DB0ANN/db0ann-beacon-hw/README.md

# db0ann-beacon-hw
Hardware documentation of db0ann beacon
