DB0ANN/db0ann-beacon-hw/beacon-control-ng/Pinning-list-uC.md

Micro controler Pinning list

| Pin | Type | Port  | Net Name | 5V Tolerant |
|-----|---|---|---|---|
| 1 | Supply  | V_BAT | +3.3V | n/a |
| 2 | I/O | PC13  | X_IO2 | No |
| 3 | I/O | PC14  | X_IO3 | No |
| 4 | I/O | PC15  | X_IO1 | No |
| 5 | In | PD0 | RCC_OSC_IN | No |
| 6 | Out | PD1 | RCC_OSC_OUT | No |
| 7 | In | NRST  | RST | No |
| 8 | Analog  | PC0 | AIN10 | No |
| 9 | Analog  | PC1 | AIN11 | No |
| 10  | Analog  | PC2 | AIN12 | No |
| 11  | Analog  | PC3 | AIN13 | No |
| 12  | Supply  | V_SSA | GND | n/a |
| 13  | Supply  | V_DDA | VDDA/+3.3V | n/a |
| 14  | Analog  | PA0 | AIN0 | No |
| 15  | Analog  | PA1 | AIN1 | No |
| 16  | Out | PA2 | UART_TX | No |

| Pin | Type | Port  | Net Name | 5V Tolerant |
|-----|---|---|---|---|
| 17  | In | PA3 | UART_RX | No |
| 18  | Supply  | V_SS4 | GND | n/a |
| 19  | Supply  | V_DD4 | +3.3V | n/a |
| 20  | Out | PA4 | SW_E | No |
| 21  | Out | PA5 | SW_D | No |
| 22  | Out | PA6 | SW_C | No |
| 23  | Out | PA7 | SW_B | No |
| 24  | Out | PC4 | SW_A | No |
| 25  | Out | PC5 | SW_H | No |
| 26  | Out | PB0 | SW_J | No |
| 27  | Out | PB1 | SW_I | No |
| 28  | Out | PB2 | SW_G | Yes |
| 29  | Out | PB10  | SW_F | Yes |
| 30  | In | PB11  | FRONT_KEY_F | Yes |
| 31  | Supply  | V_SS1 | GND | n/a |
| 32  | Supply  | V_DD1 | +3.3V | n/a |

| Pin | Type | Port  | Net Name | 5V Tolerant |
|-----|---|---|---|---|
| 33  | In | PB12  | J_F | Yes |
| 34  | In | PB13  | I_F | Yes |
| 35  | In | PB14  | H_F | Yes |
| 36  | In | PB15  | G_F | Yes |
| 37  | In | PC6 | F_F | Yes |
| 38  | In | PC7 | E_F | Yes |
| 39  | In | PC8 | D_F | Yes |
| 40  | In | PC9 | C_F | Yes |
| 41  | In | PA8 | B_F | Yes |
| 42  | In | PA9 | A_F | Yes |
| 43  | In | PA10  | ~J_F | Yes |
| 44  | In | PA11  | ~I_F | Yes |
| 45  | In | PA12  | ~H_F | Yes |
| 46  | Out_I/O | PA13  | JTAG_TMS_SWDIO | Yes |
| 47  | Supply  | V_SS2 | GND | n/a |
| 48  | Supply  | V_DD2 | +3.3V | n/a |

| Pin | Type | Port  | Net Name | 5V Tolerant |
|-----|---|---|---|---|
| 49  | Out | PA14  | JTAG_TCK_SWCLK | Yes |
| 50  | Out | PA15  | JTAG_TDI | Yes |
| 51  | In | PC10  | ~G_F | Yes |
| 52  | In | PC11  | ~F_F | Yes |
| 53  | In | PC12  | ~E_F | Yes |
| 54  | In | PD2 | ~D_F | Yes |
| 55  | In | PB3 | JTAG_TDO_SWO | Yes |
| 56  | In | PB4 | ~C_F | Yes |
| 57  | Out | PB5 | CW_GEN | ? |
| 58  | In | PB6 | ~B_F | Yes |
| 59  | In | PB7 | ~A_F | Yes |
| 60  | In | BOOT0 | Boot | ? |
| 61  | Out | PB8 | I2C1_SCL | Yes |
| 62  | I/O | PB9 | I2C1_SDA | Yes |
| 63  | Supply  | V_SS3 | GND | n/a |
| 64  | Supply  | V_DD3 | +3.3V | n/a |
