DB0ANN/db0ann-beacon-hw/beacon-control-ng/beacon-control-ng.kicad_pcb

## KiCad design beacon-control-ng/beacon-control-ng.kicad_pcb (2020-06-21)

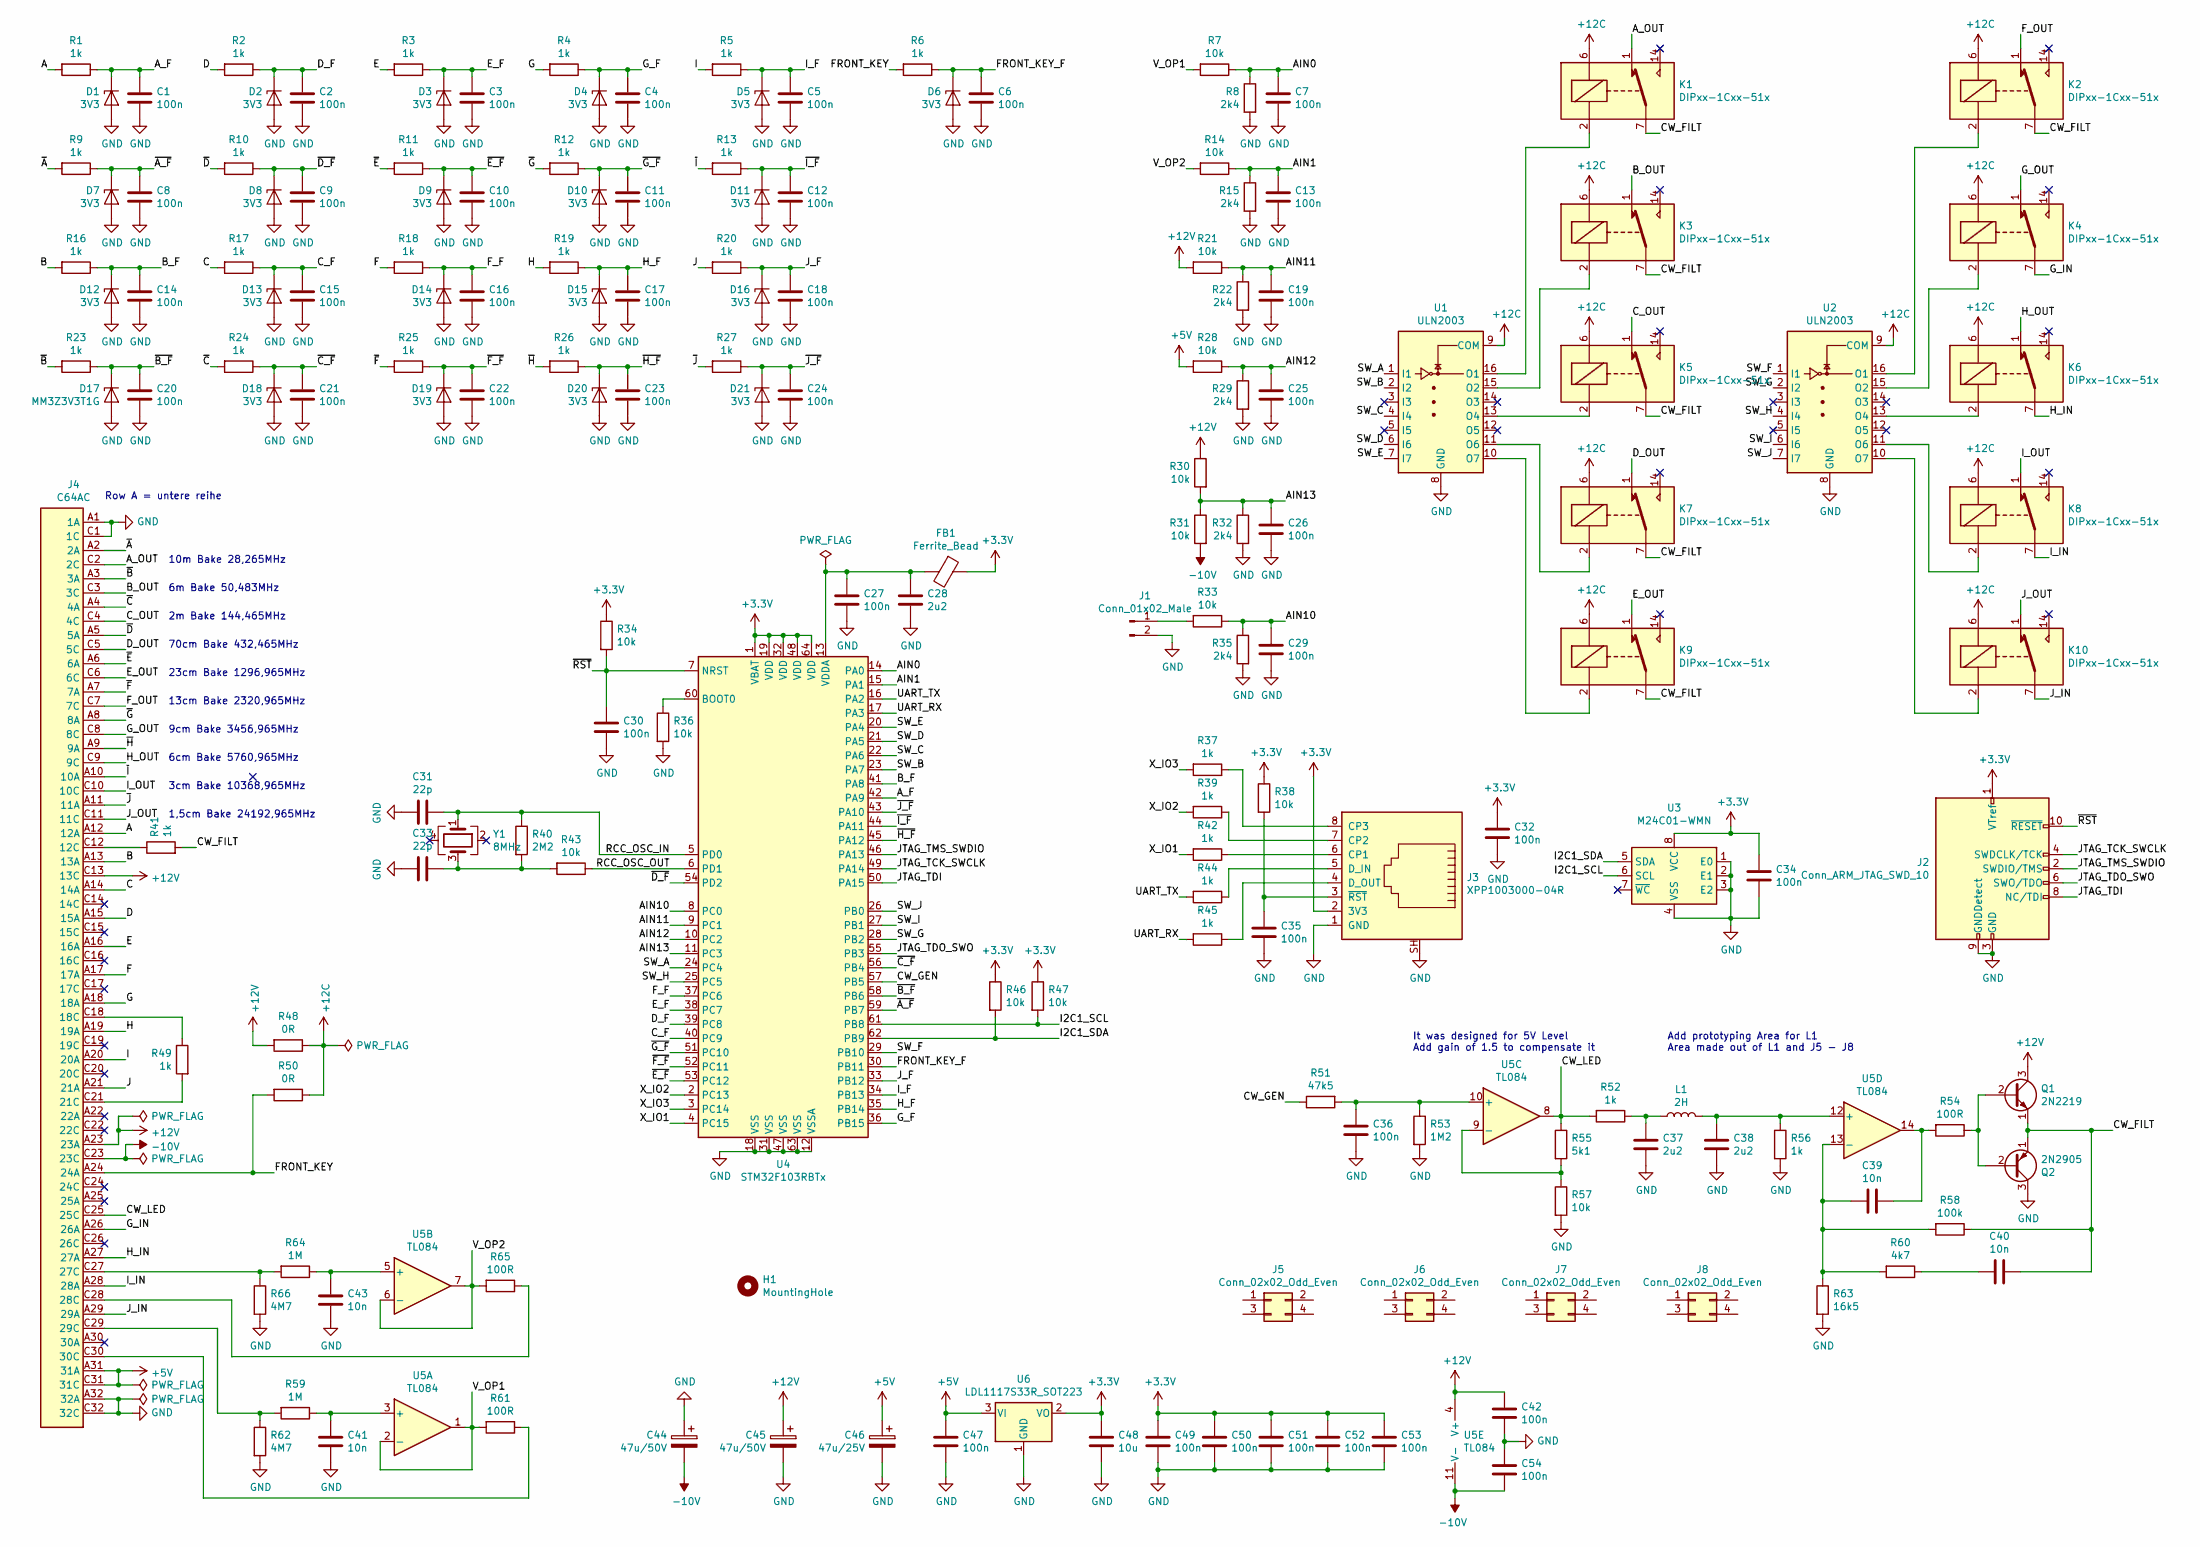
[picture p1: schematic beacon-control-ng.sch, beacon control ng]

Parts:
C1, C2, C3, C4, C5, C6, C7, C8, C9, C10, C11, C12, C13, C14, C15, C16, C17, C18, C19, C20, C21, C22, C23, C24, C25, C26, C27, C29, C30, C32, C34, C35, C36, C42, C47, C49, C50, C51, C52, C53, C54: 100n; C_0805_2012Metric
C28, C37, C38: 2u2; C_1206_3216Metric
C31, C33: 22p; C_0805_2012Metric
C39, C40, C41, C43: 10n; C_0805_2012Metric
C44, C45: 47u/50V; CP_Elec_8x10.5
C46: 47u/25V; CP_Elec_8x10.5
C48: 10u; C_1206_3216Metric
D1, D2, D3, D4, D5, D6, D7, D8, D9, D10, D11, D12, D13, D14, D15, D16, D18, D19, D20, D21: 3V3; D_SOD-323
D17: MM3Z3V3T1G; D_SOD-323
FB1: Ferrite_Bead; L_0805_2012Metric
H1: MountingHole; MountingHole_3.2mm_M3
J1: Conn_01x02_Male; PinHeader_1x02_P2.54mm_Vertical
J2: Conn_ARM_JTAG_SWD_10; PinHeader_2x05_P1.27mm_Vertical_SMD
J3: XPP1003000-04R; Lantronix_xPort_Pro
J4: C64AC; DIN41612_C_2x32_Horizontal
J5, J6, J7, J8: Conn_02x02_Odd_Even; PinHeader_2x16_P2.54mm_Vertical
K1, K2, K3, K4, K5, K6, K7, K8, K9, K10: DIPxx-1Cxx-51x; Relay_StandexMeder_DIP_LowProfile
L1: 2H; PinHeader_2x16_P2.54mm_Vertical
Q1: 2N2219; TO-39-3
Q2: 2N2905; TO-39-3
R1, R2, R3, R4, R5, R6, R9, R10, R11, R12, R13, R16, R17, R18, R19, R20, R23, R24, R25, R26, R27, R37, R39, R41, R42, R44, R45, R49, R52, R56: 1k; R_0805_2012Metric
R7, R14, R21, R28, R30, R31, R33, R34, R36, R38, R43, R46, R47, R57: 10k; R_0805_2012Metric
R8, R15, R22, R29, R32, R35: 2k4; R_0805_2012Metric
R40: 2M2; R_0805_2012Metric
R48, R50: 0R; R_0805_2012Metric
R51: 47k5; R_0805_2012Metric
R53: 1M2; R_0805_2012Metric
R54, R61, R65: 100R; R_0805_2012Metric
R55: 5k1; R_0805_2012Metric
R58: 100k; R_0805_2012Metric
R59, R64: 1M; R_0805_2012Metric
R60: 4k7; R_0805_2012Metric
R62, R66: 4M7; R_0805_2012Metric
R63: 16k5; R_0805_2012Metric
U1, U2: ULN2003; SOIC-16_3.9x9.9mm_P1.27mm
U3: M24C01-WMN; SOIC-8_3.9x4.9mm_P1.27mm
U4: STM32F103RBTx; LQFP-64_10x10mm_P0.5mm
U5: TL084; SOIC-14_3.9x8.7mm_P1.27mm
U6: LDL1117S33R_SOT223; SOT-223-3_TabPin2
Y1: 8MHz; Crystal_SMD_EuroQuartz_MQ-4Pin_7.0x5.0mm

Connections:
+3V3: C32.1, C34.1, C48.1, C49.1, C50.1, C51.1, C52.1, C53.1, FB1.1, J2.1 (VTref), J3.2 (3V3), R34.1, R38.1, R46.1, R47.1, U3.8 (VCC), U4.1 (VBAT), U4.19 (VDD), U4.32 (VDD), U4.48 (VDD), U4.64 (VDD), U6.2 (VO)
+5V: C46.1, C47.1, J4.A31 (31A), J4.C31 (31C), R28.2, U6.3 (VI)
+12C: K1.6, K2.6, K3.6, K4.6, K5.6, K6.6, K7.6, K8.6, K9.6, K10.6, R48.1, R50.1, U1.9 (COM), U2.9 (COM)
+12V: C42.1, C45.1, J4.A23 (23A), J4.C13 (13C), Q1.3 (C), R21.2, R30.1, R48.2, U5.4 (V+)
-10V: C44.2, C54.2, J4.C23 (23C), R31.2, U5.11 (V-)
/A: J4.A12 (12A), R1.2
/AIN0: C7.1, R7.1, R8.1, U4.14 (PA0)
/AIN1: C13.1, R14.1, R15.1, U4.15 (PA1)
/AIN10: C29.1, R33.1, R35.1, U4.8 (PC0)
/AIN11: C19.1, R21.1, R22.1, U4.9 (PC1)
/AIN12: C25.1, R28.1, R29.1, U4.10 (PC2)
/AIN13: C26.1, R30.2, R31.1, R32.1, U4.11 (PC3)
/A_F: C1.1, D1.1 (K), R1.1, U4.42 (PA9)
/A_OUT: J4.C2 (2C), K1.1
/B: J4.A13 (13A), R16.2
/B_F: C14.1, D12.1 (K), R16.1, U4.41 (PA8)
/B_OUT: J4.C3 (3C), K3.1
/C: J4.A14 (14A), R17.2
/CW_FILT: C40.1, K1.7, K1.8, K2.7, K2.8, K3.7, K3.8, K5.7, K5.8, K7.7, K7.8, K9.7, K9.8, Q1.1 (E), Q2.1 (E), R41.2, R58.1
/CW_GEN: R51.1, U4.57 (PB5)
/CW_LED: J4.C25 (25C), R52.2, R55.1, U5.8
/C_F: C15.1, D13.1 (K), R17.1, U4.40 (PC9)
/C_OUT: J4.C4 (4C), K5.1
/D: J4.A15 (15A), R2.2
/D_F: C2.1, D2.1 (K), R2.1, U4.39 (PC8)
/D_OUT: J4.C5 (5C), K7.1
/E: J4.A16 (16A), R3.2
/E_F: C3.1, D3.1 (K), R3.1, U4.38 (PC7)
/E_OUT: J4.C6 (6C), K9.1
/F: J4.A17 (17A), R18.2
/FRONT_KEY: J4.A24 (24A), R6.2, R50.2
/FRONT_KEY_F: C6.1, D6.1 (K), R6.1, U4.30 (PB11)
/F_F: C16.1, D14.1 (K), R18.1, U4.37 (PC6)
/F_OUT: J4.C7 (7C), K2.1
/G: J4.A18 (18A), R4.2
/G_F: C4.1, D4.1 (K), R4.1, U4.36 (PB15)
/G_IN: J4.A26 (26A), K4.7, K4.8
/G_OUT: J4.C8 (8C), K4.1
/H: J4.A19 (19A), R19.2
/H_F: C17.1, D15.1 (K), R19.1, U4.35 (PB14)
/H_IN: J4.A27 (27A), K6.7, K6.8
/H_OUT: J4.C9 (9C), K6.1
/I: J4.A20 (20A), R5.2
/I2C1_SCL: R47.2, U3.6 (SCL), U4.61 (PB8)
/I2C1_SDA: R46.2, U3.5 (SDA), U4.62 (PB9)
/I_F: C5.1, D5.1 (K), R5.1, U4.34 (PB13)
/I_IN: J4.A28 (28A), K8.7, K8.8
/I_OUT: J4.C10 (10C), K8.1
/J: J4.A21 (21A), R20.2
/JTAG_TCK_SWCLK: J2.4 (SWDCLK/TCK), U4.49 (PA14)
/JTAG_TDI: J2.8 (NC/TDI), U4.50 (PA15)
/JTAG_TDO_SWO: J2.6 (SWO/TDO), U4.55 (PB3)
/JTAG_TMS_SWDIO: J2.2 (SWDIO/TMS), U4.46 (PA13)
/J_F: C18.1, D16.1 (K), R20.1, U4.33 (PB12)
/J_IN: J4.A29 (29A), K10.7, K10.8
/J_OUT: J4.C11 (11C), K10.1
/RCC_OSC_IN: C31.1, R40.1, U4.5 (PD0), Y1.1
/RCC_OSC_OUT: R43.1, U4.6 (PD1)
/SW_A: U1.1 (I1), U4.24 (PC4)
/SW_B: U1.2 (I2), U4.23 (PA7)
/SW_C: U1.4 (I4), U4.22 (PA6)
/SW_D: U1.6 (I6), U4.21 (PA5)
/SW_E: U1.7 (I7), U4.20 (PA4)
/SW_F: U2.1 (I1), U4.29 (PB10)
/SW_G: U2.2 (I2), U4.28 (PB2)
/SW_H: U2.4 (I4), U4.25 (PC5)
/SW_I: U2.6 (I6), U4.27 (PB1)
/SW_J: U2.7 (I7), U4.26 (PB0)
/UART_RX: R45.2, U4.17 (PA3)
/UART_TX: R44.2, U4.16 (PA2)
/V_OP1: R7.2, R61.2, U5.1, U5.2 (-)
/V_OP2: R14.2, R65.2, U5.6 (-), U5.7
/X_IO1: R42.2, U4.4 (PC15)
/X_IO2: R39.2, U4.2 (PC13)
/X_IO3: R37.2, U4.3 (PC14)
/~A: J4.A2 (2A), R9.2
/~A_F: C8.1, D7.1 (K), R9.1, U4.59 (PB7)
/~B: J4.A3 (3A), R23.2
/~B_F: C20.1, D17.1 (K), R23.1, U4.58 (PB6)
/~C: J4.A4 (4A), R24.2
/~C_F: C21.1, D18.1 (K), R24.1, U4.56 (PB4)
/~D: J4.A5 (5A), R10.2
/~D_F: C9.1, D8.1 (K), R10.1, U4.54 (PD2)
/~E: J4.A6 (6A), R11.2
/~E_F: C10.1, D9.1 (K), R11.1, U4.53 (PC12)
/~F: J4.A7 (7A), R25.2
/~F_F: C22.1, D19.1 (K), R25.1, U4.52 (PC11)
/~G: J4.A8 (8A), R12.2
/~G_F: C11.1, D10.1 (K), R12.1, U4.51 (PC10)
/~H: J4.A9 (9A), R26.2
/~H_F: C23.1, D20.1 (K), R26.1, U4.45 (PA12)
/~I: J4.A10 (10A), R13.2
/~I_F: C12.1, D11.1 (K), R13.1, U4.44 (PA11)
/~J: J4.A11 (11A), R27.2
/~J_F: C24.1, D21.1 (K), R27.1, U4.43 (PA10)
/~RST: C30.1, J2.10 (~RESET~), R34.2, U4.7 (NRST)
GND: C1.2, C2.2, C3.2, C4.2, C5.2, C6.2, C7.2, C8.2, C9.2, C10.2, C11.2, C12.2, C13.2, C14.2, C15.2, C16.2, C17.2, C18.2, C19.2, C20.2, C21.2, C22.2, C23.2, C24.2, C25.2, C26.2, C27.2, C28.2, C29.2, C30.2, C31.2, C32.2, C33.2, C34.2, C35.2, C36.2, C37.2, C38.2, C41.2, C42.2, C43.2, C44.1, C45.2, C46.2, C47.2, C48.2, C49.2, C50.2, C51.2, C52.2, C53.2, C54.1, D1.2 (A), D2.2 (A), D3.2 (A), D4.2 (A), D5.2 (A), D6.2 (A), D7.2 (A), D8.2 (A), D9.2 (A), D10.2 (A), D11.2 (A), D12.2 (A), D13.2 (A), D14.2 (A), D15.2 (A), D16.2 (A), D17.2 (A), D18.2 (A), D19.2 (A), D20.2 (A), D21.2 (A), J1.2, J2.3 (GND), J2.5 (GND), J2.9 (GNDDetect), J3.1 (GND), J3.SH, J4.A1 (1A), J4.A32 (32A), J4.C1 (1C), J4.C32 (32C), Q2.3 (C), R8.2, R15.2, R22.2, R29.2, R32.2, R35.2, R36.2, R53.2, R56.2, R57.2, R62.2, R63.2, R66.2, U1.8 (GND), U2.8 (GND), U3.1 (E0), U3.2 (E1), U3.3 (E2), U3.4 (VSS), U4.12 (VSSA), U4.18 (VSS), U4.31 (VSS), U4.47 (VSS), U4.63 (VSS), U6.1 (GND)
unnamed: C27.1, C28.1, FB1.2, U4.13 (VDDA)
unnamed: C33.1, R40.2, R43.2, Y1.3
unnamed: C35.1, J3.3 (~RST), R38.2
unnamed: C36.1, R51.2, R53.1, U5.10 (+)
unnamed: C37.1, L1.1, R52.1
unnamed: C38.1, L1.2, R56.1, U5.12 (+)
unnamed: C39.1, R54.2, U5.14
unnamed: C39.2, R58.2, R60.2, R63.1, U5.13 (-)
unnamed: C40.2, R60.1
unnamed: C41.1, R59.1, U5.3 (+)
unnamed: C43.1, R64.1, U5.5 (+)
unnamed: J1.1, R33.2
unnamed: J3.4 (D_OUT), R45.1
unnamed: J3.5 (D_IN), R44.1
unnamed: J3.6 (CP1), R42.1
unnamed: J3.7 (CP2), R39.1
unnamed: J3.8 (CP3), R37.1
unnamed: J4.C12 (12C), R41.1
unnamed: J4.C18 (18C), R49.1
unnamed: J4.C21 (21C), R49.2
unnamed: J4.C27 (27C), R64.2, R66.1
unnamed: J4.C28 (28C), R65.1
unnamed: J4.C29 (29C), R59.2, R62.1
unnamed: J4.C30 (30C), R61.1
unnamed: K1.2, U1.16 (O1)
unnamed: K2.2, U2.16 (O1)
unnamed: K3.2, U1.15 (O2)
unnamed: K4.2, U2.15 (O2)
unnamed: K5.2, U1.13 (O4)
unnamed: K6.2, U2.13 (O4)
unnamed: K7.2, U1.11 (O6)
unnamed: K8.2, U2.11 (O6)
unnamed: K9.2, U1.10 (O7)
unnamed: K10.2, U2.10 (O7)
unnamed: Q1.2 (B), Q2.2 (B), R54.1
unnamed: R36.1, U4.60 (BOOT0)
unnamed: R55.2, R57.1, U5.9 (-)

Notes on the sheet:
Row A = untere reihe
It was designed for 5V Level Add gain of 1.5 to compensate it
10m Bake 28,265MHz
6m Bake 50,483MHz
70cm Bake 432,465MHz
2m Bake 144,465MHz
23cm Bake 1296,965MHz
13cm Bake 2320,965MHz
9cm Bake 3456,965MHz
6cm Bake 5760,965MHz
3cm Bake 10368,965MHz
1,5cm Bake 24192,965MHz
Add prototyping Area for L1 Area made out of L1 and J5 - J8

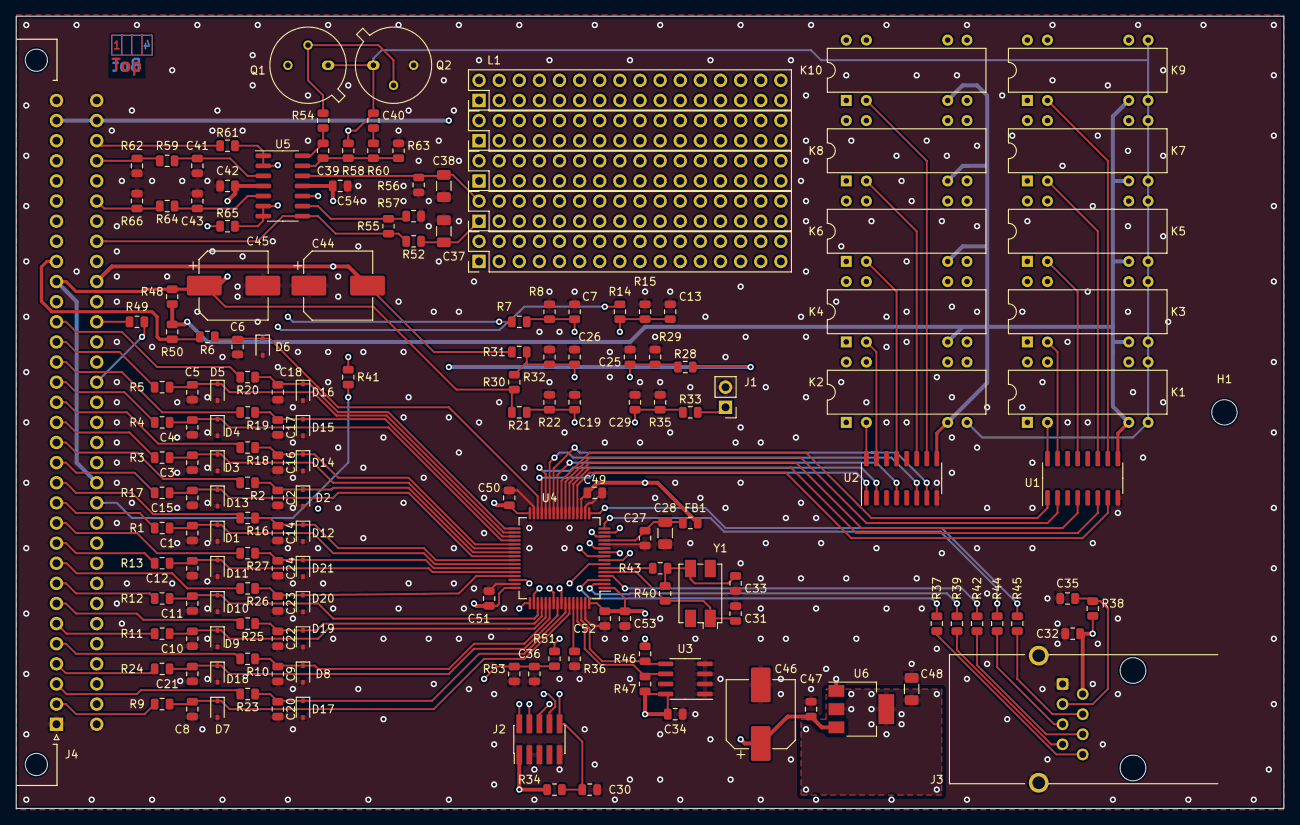
[picture p2: board beacon-control-ng.kicad_pcb from above]

Board: 4 copper layers, 160.0 x 100.0 mm, 171 parts (0 on the bottom side), 134 nets.
