DB0ANN/db0ann-beacon-hw/(commit log)

2020-03-16 wip reverse engineering of control unit
    [Steuerung.kicad_pcb, Steuerung.sch]
2020-03-17 some more reverse engineering
    [Steuerung.sch]
2020-03-20 Finished reverse engineering
    [Steuerung.sch]
2020-03-20 Some refactoring
    [Steuerung.sch]
2020-03-21 Add missing part values
    [Steuerung.sch]
2020-04-01 First draft of new beacon control hw
    [beacon-control-ng.kicad_pcb, beacon-control-ng.sch]
2020-04-10 Add design document + small schematic fixes
    [beacon-control-ng.sch]
2020-05-03 Commit layout work in progress
    [beacon-control-ng.kicad_pcb, beacon-control-ng.sch]
2020-06-11 Finished layout
    [beacon-control-ng.kicad_pcb]
2020-06-21 Place designators on assembly printing
    [beacon-control-ng.kicad_pcb]
